sashu2006/Precision-Analog-Calculator/Full_Circuit_Image.png

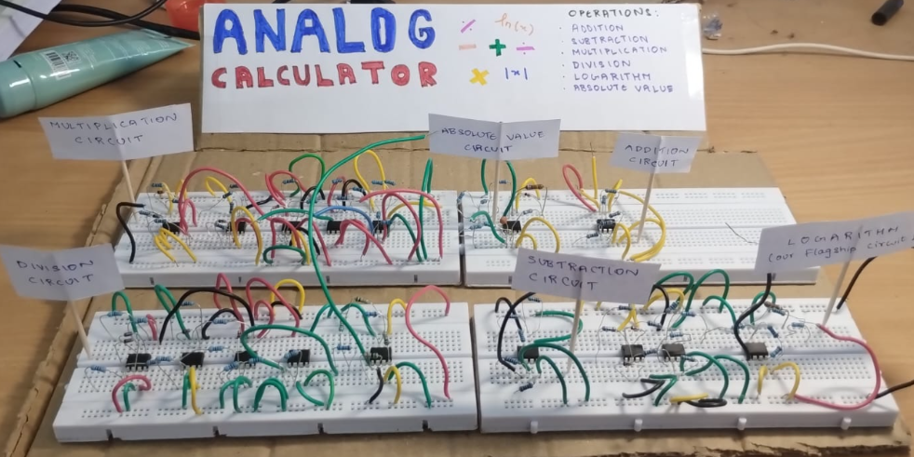
Full_Circuit_Image.png
