sashu2006/Precision-Analog-Calculator/absolute_value Circuit.asc

C1: Cap; 10p
D1: Diode
R1: Res; 18k
R2: Res; 9.1k
R3: Res; 33k
R4: Res; 60.7k
U1: LT1013
U2: LT1013
V1: Voltage; -8.54
V2: Voltage; 12
V3: Voltage; -12
V4: Voltage; 12
V5: Voltage; -12
Named nets: 0, Vout, Vin
.tran 0 10ms 0 1m
