sashu2006/Precision-Analog-Calculator/Adder_Circuit.asc

-VDD: voltage; -15
R1: res; 4.3k
R2: res; 4.3k
R3: res; 4.3k
R4: res; 4.3k
R5: res; 4.3k
U1: LT1013
U2: LT1013
V1: voltage; 8.21; AC 0
V2: voltage; 1.16; AC 0
VDD: voltage; 15
Named nets: 0, VDD, -VDD, Vout
.tran 0 10m 0 0.01m
