sashu2006/Precision-Analog-Calculator/Divider_Circuit.asc

-VDD: voltage; -15
D1: diode; 1N4148
D2: diode; 1N4148
D3: diode; 1N4148
D4: diode; 1N4148
R1: res; 5k
R2: res; 5k
R3: res; 5k
R4: res; 5k
R5: res; 5k
R6: res; 5k
R7: res; 5k
R8: res; 5k
R9: res; 5k
R10: res; 5k
R11: res; 5k
R12: res; 5k
U1: LT1013
U2: LT1013
U3: LT1013
U4: LT1013
U5: LT1013
U6: LT1013
U7: LT1013
V1: voltage; 8
V2: voltage; 3
VDD: voltage; 15
VR: voltage; 1
Named nets: 0, VDD, -VDD, Vout
.tran 0 10m 0 1m
