sashu2006/Precision-Analog-Calculator/Logarithm_Circuit.asc

-VDD: voltage; -15
B1: bv; V = V(Vout)/0.045474
D1: diode; 1N4148
D2: diode; 1N4148
R1: res; 1k
R2: res; 1k
R3: res; 1k
R4: res; 1k
R5: res; 1k
R6: res; 1k
R7: res; 1k
U1: LT1013
U2: LT1013
U3: LT1013
U4: LT1013
V1: voltage; 2
V2: voltage; 1
VDD: voltage; 15
Named nets: 0, -VDD, VDD, Vout, Vout_real
.tran 0 10m 0 0.01m
I found that the eeta value is 1.749, hence the real o/p is V(Vout)/0.045474
