sashu2006/Precision-Analog-Calculator/sqrt.asc

C1: cap; 1n
C2: cap; 1n
C3: cap; 1n
C4: cap; 1n
Q1: npn; 2N4124
Q2: npn; 2N4124
Q3: npn; 2N4124
Q4: npn; 2N4124
R1: res; 40k
R2: res; 10k
R3: res; 10k
R4: res; 10k
U1: LT1013
U2: LT1013
U3: LT1013
U4: LT1013
V1: voltage; 2
V2: voltage; 4
V3: voltage; 12
V4: voltage; -12
Named nets: 0, VDD, -VDD, Vout
.tran 0 10ms 0 1ms
