sashu2006/Precision-Analog-Calculator/Subtractor_Circuit.asc

-VDD: voltage; -15
R1: res; 5k
R2: res; 5k
R3: res; 5k
R4: res; 5k
R5: res; 5k
U1: LT1013
U2: LT1013
V1: voltage; 3.5
V2: voltage; 2.16
VDD: voltage; 15
Named nets: 0, -VDD, VDD, Vout
The circuit does Vout = V1- V2 for suitable ranges of input
.tran 0 10m 0 0.01m
